ManoelDeveloper-alt/PIBIC-2024-25/helius/outros/internet/info.txt

execulte o gerenciador com sudo (sudo python3 gerenciador.py)
instale o iwlist (sudo apt install wireless-tools)
instale o udhcpc (sudo apt install udhcpc)
