ManoelDeveloper-alt/PIBIC-2024-25/Files/raspberry_pin.png

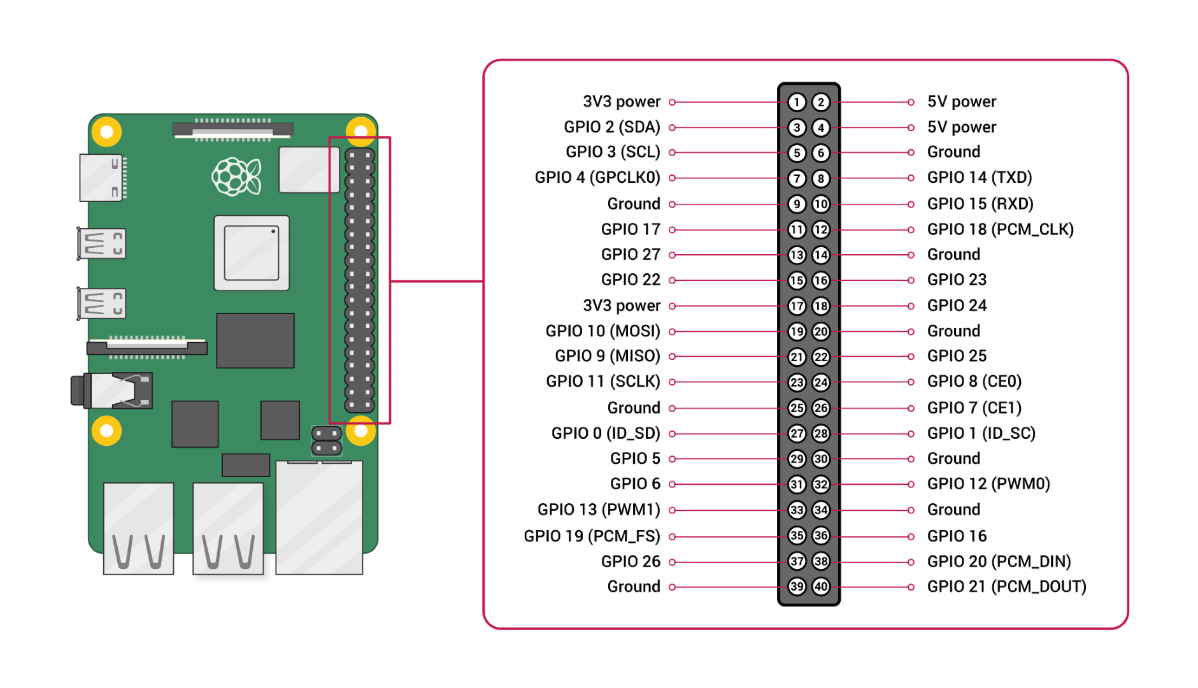
Files/raspberry_pin.png
