ManoelDeveloper-alt/PIBIC-2024-25/3d/esfera_certo.stl

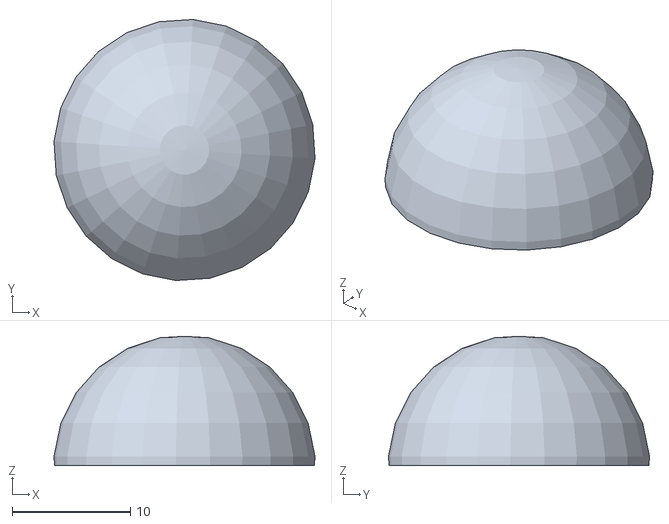
[picture p2: CAD file, 2025-09-12]
3d/esfera_certo.stl
22.0 x 22.0 x 10.9
