ManoelDeveloper-alt/PIBIC-2024-25/3d/roda_pequena.stl

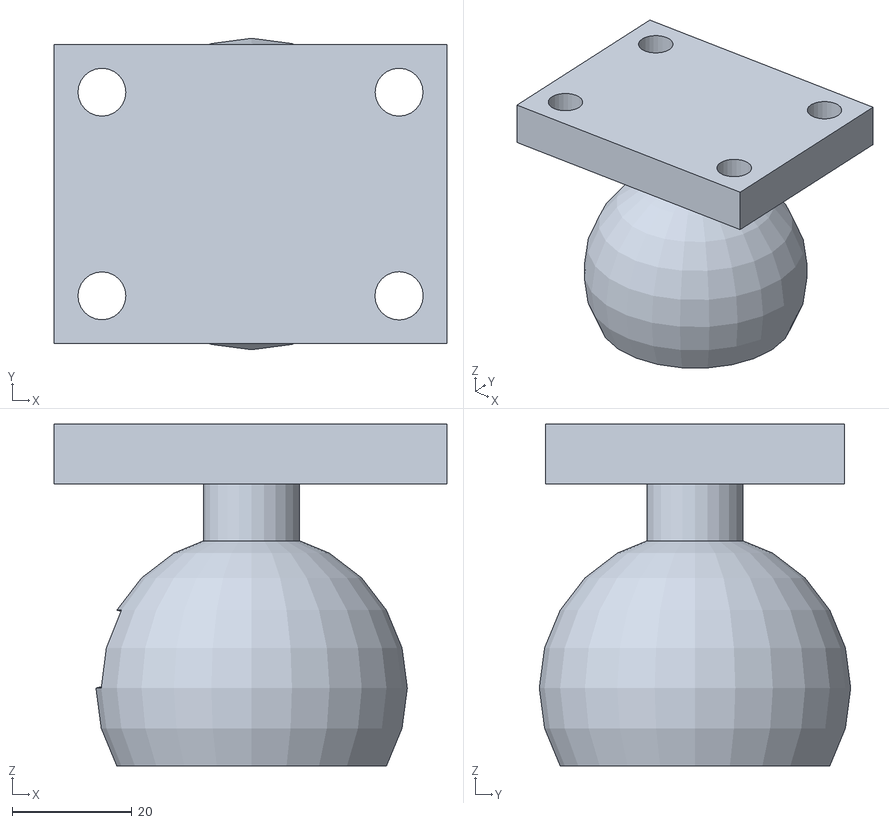
[picture p3: CAD file, 2025-09-12]
3d/roda_pequena.stl
65.6 x 52.0 x 57.1
