ManoelDeveloper-alt/PIBIC-2024-25/3d/esfera_1B.stl

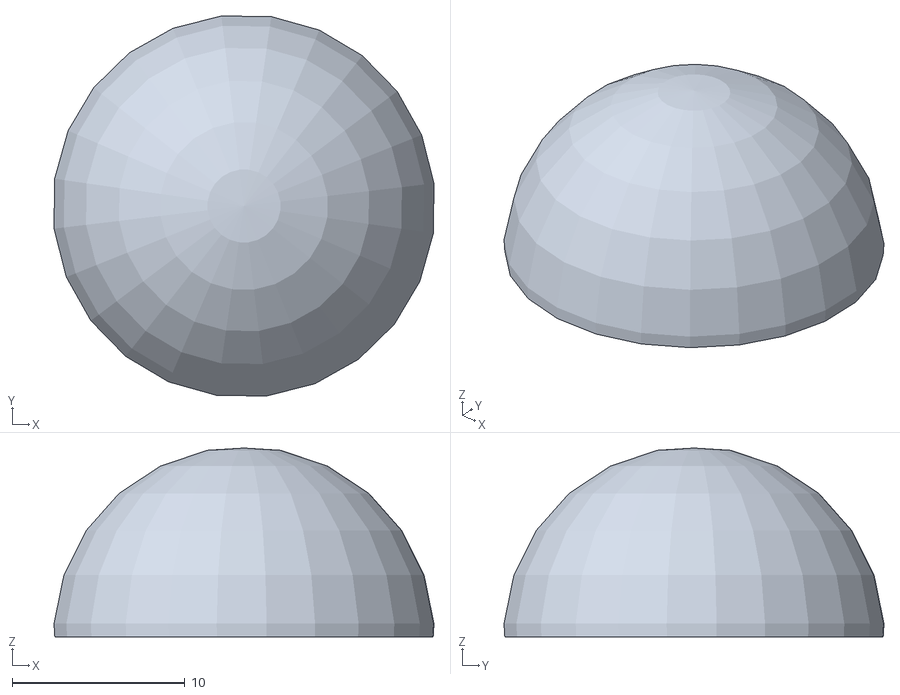
[picture p4: CAD file, 2025-09-12]
3d/esfera_1B.stl
22.0 x 22.0 x 10.9
