ManoelDeveloper-alt/PIBIC-2024-25/3d/esfera_1.stl

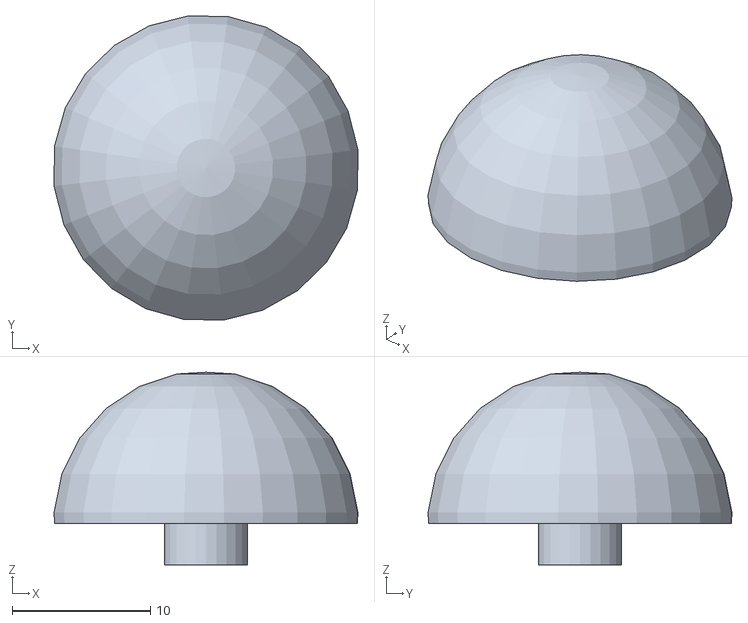
[picture p5: CAD file, 2025-09-12]
3d/esfera_1.stl
22.0 x 22.0 x 13.9
