ManoelDeveloper-alt/PIBIC-2024-25/3d/esfera_certa_dessa_vez.stl

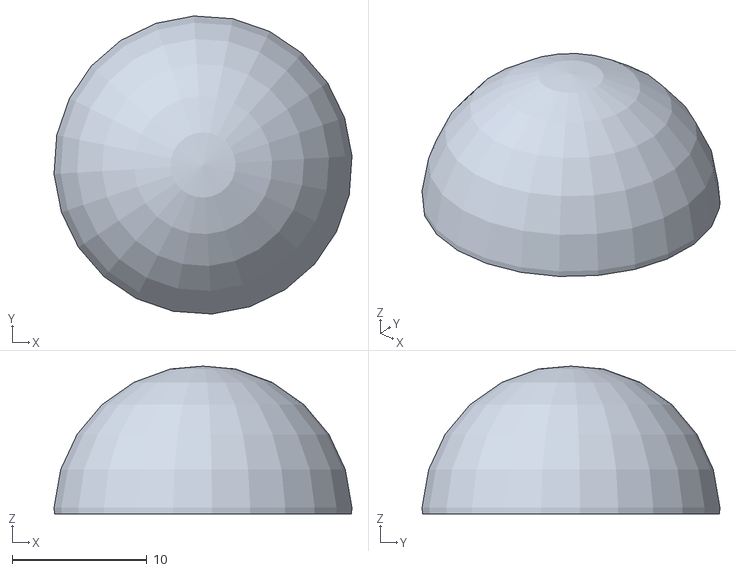
[picture p6: CAD file, 2025-09-12]
3d/esfera_certa_dessa_vez.stl
22.1 x 22.1 x 10.9
