ManoelDeveloper-alt/PIBIC-2024-25/3d/esfera.stl

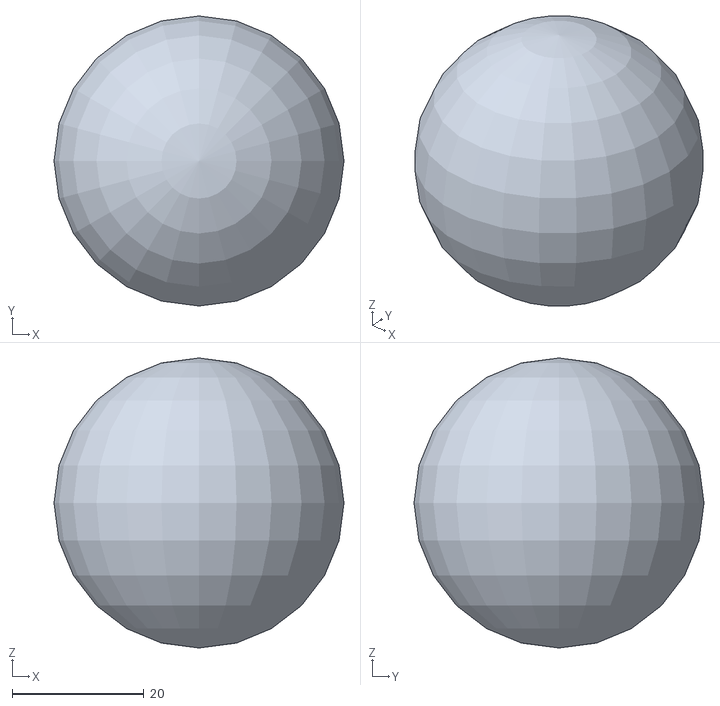
[picture p7: CAD file, 2025-09-12]
3d/esfera.stl
44.0 x 44.0 x 44.0
