ManoelDeveloper-alt/PIBIC-2024-25/3d/esferacombase.stl

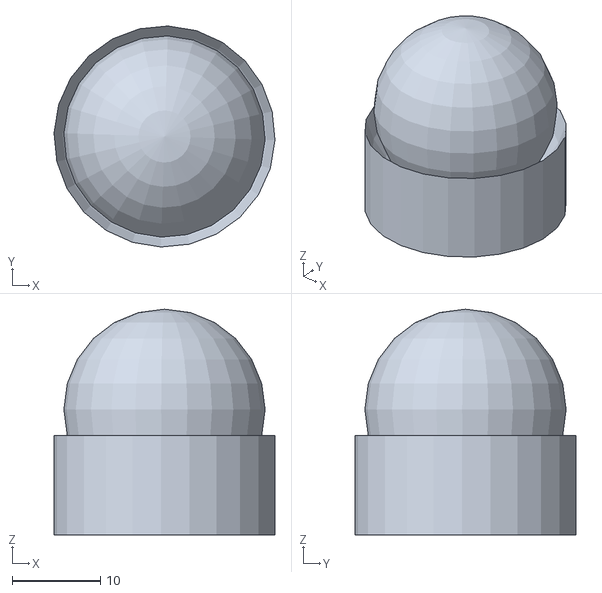
[picture p8: CAD file, 2025-09-12]
3d/esferacombase.stl
25.0 x 25.0 x 25.5
