ManoelDeveloper-alt/PIBIC-2024-25/Files/Astar - Testes/criador_de_mapa/res/borracha.png

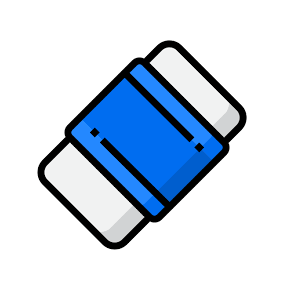
Files/Astar - Testes/criador_de_mapa/res/borracha.png
