ManoelDeveloper-alt/PIBIC-2024-25/Files/Astar - Testes/criador_de_mapa/res/lapis.png

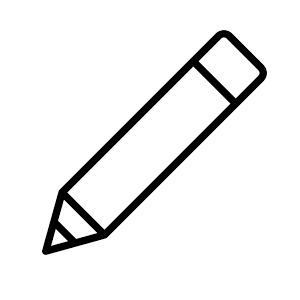
Files/Astar - Testes/criador_de_mapa/res/lapis.png
