ManoelDeveloper-alt/PIBIC-2024-25/placas/motor_energia/teste_regulador.pdf

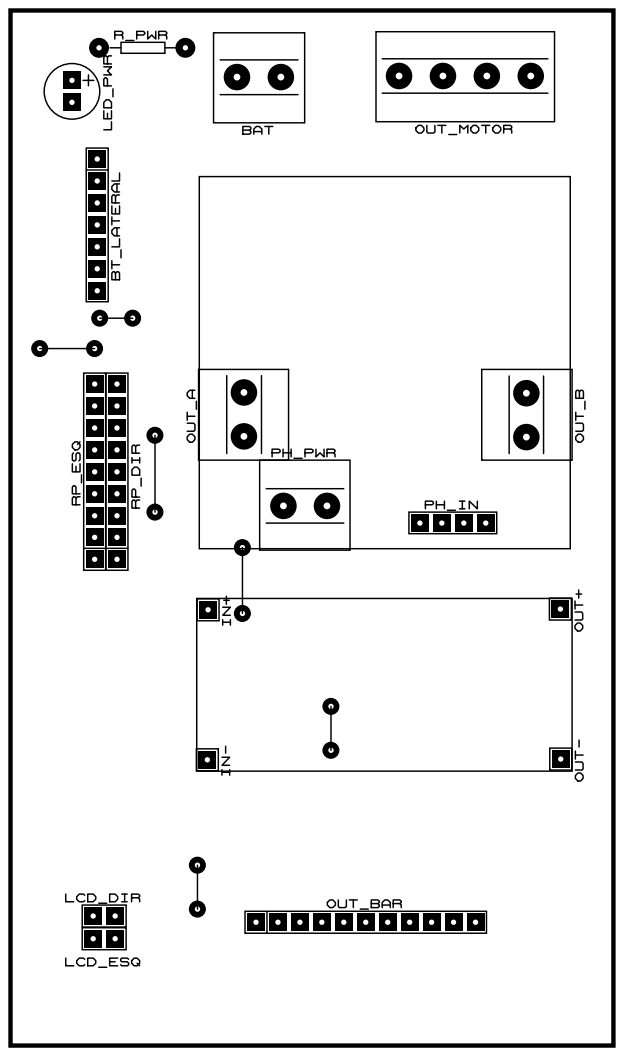
[picture p11: page 1]
