ManoelDeveloper-alt/PIBIC-2024-25/placas/motor_energia/teste_tamanho.pdf

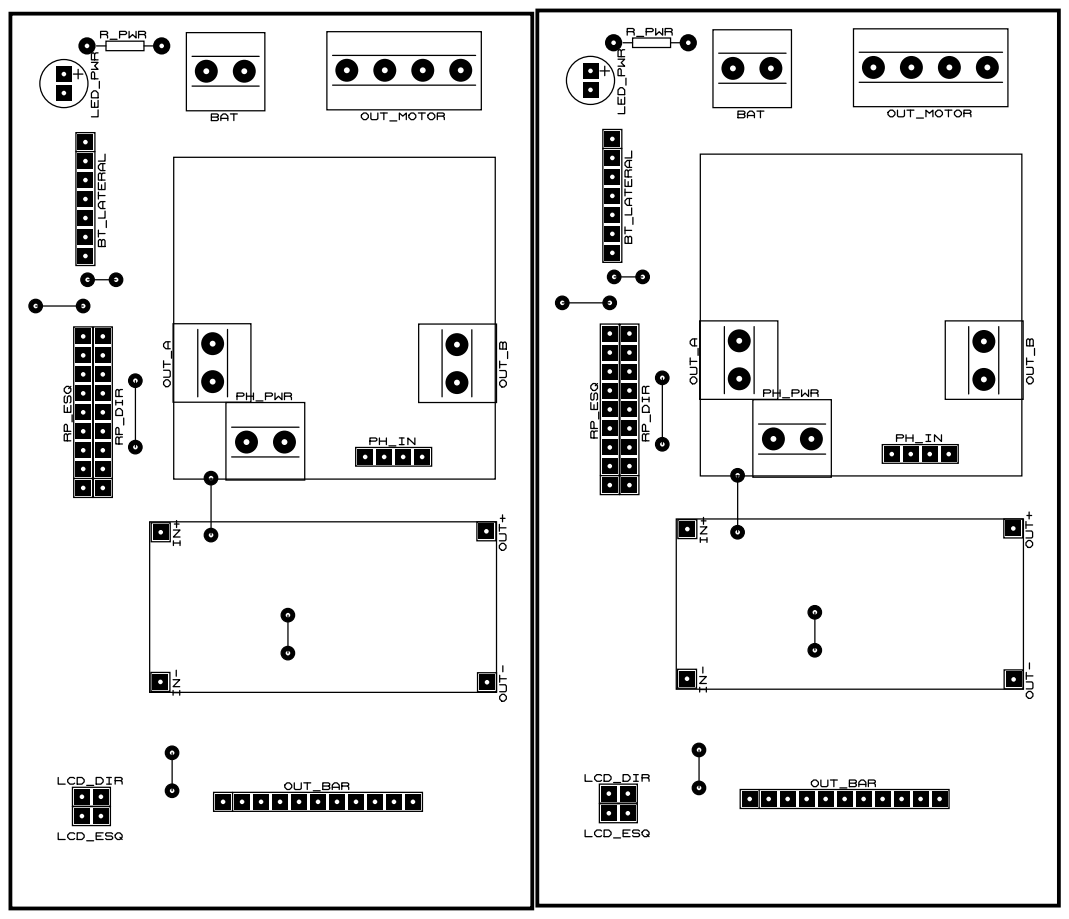
[picture p12: page 1]
