ManoelDeveloper-alt/PIBIC-2024-25/placas/principal - Wallif/teste.pdf

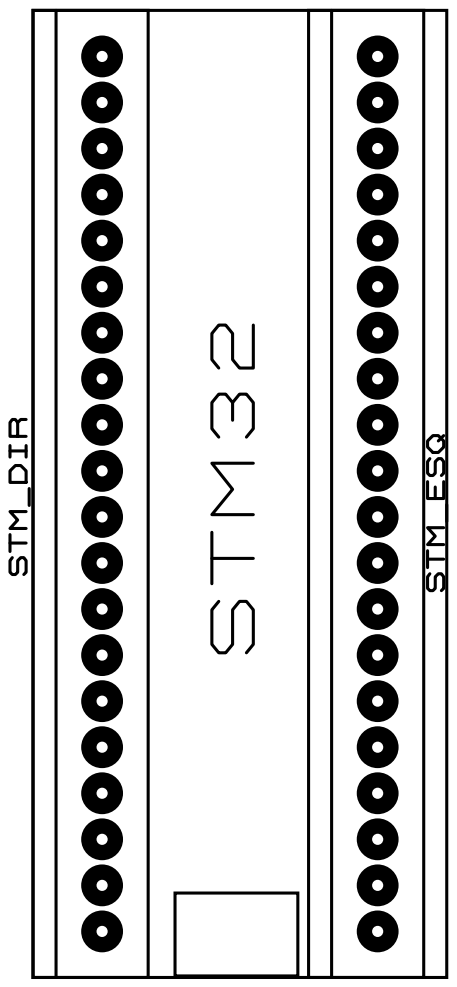
[picture p13: page 1]
