ManoelDeveloper-alt/PIBIC-2024-25/placas/linha/bottom_normal.pdf

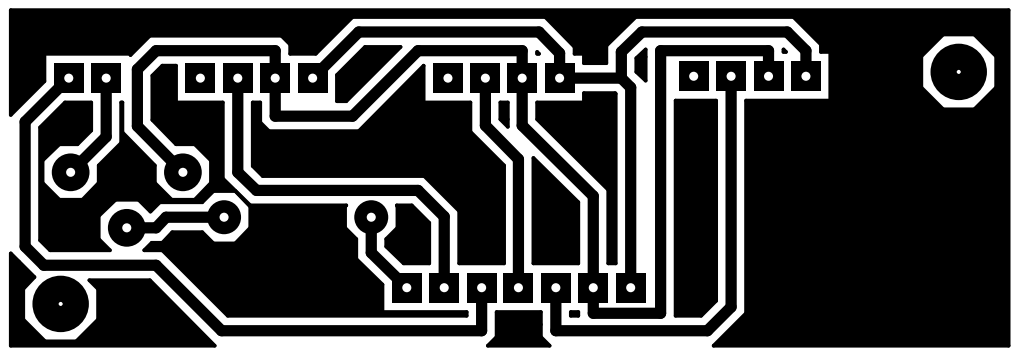
[picture p14: page 1]
