ManoelDeveloper-alt/PIBIC-2024-25/placas/linha/pads_okay.pdf

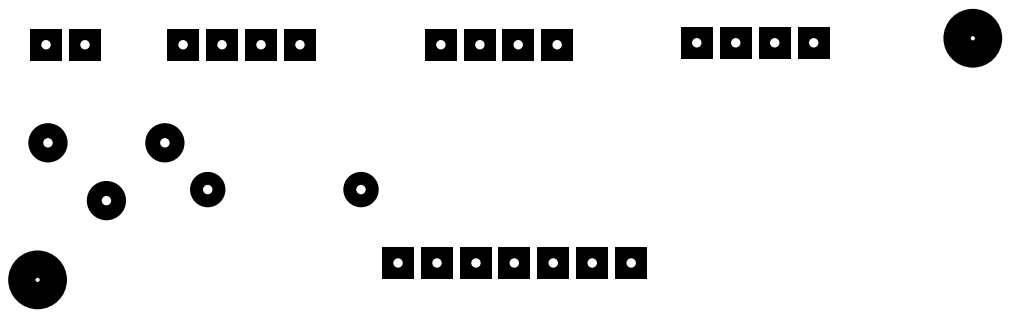
[picture p15: page 1]
