ManoelDeveloper-alt/PIBIC-2024-25/placas/motor_energia/bottom_normal.pdf

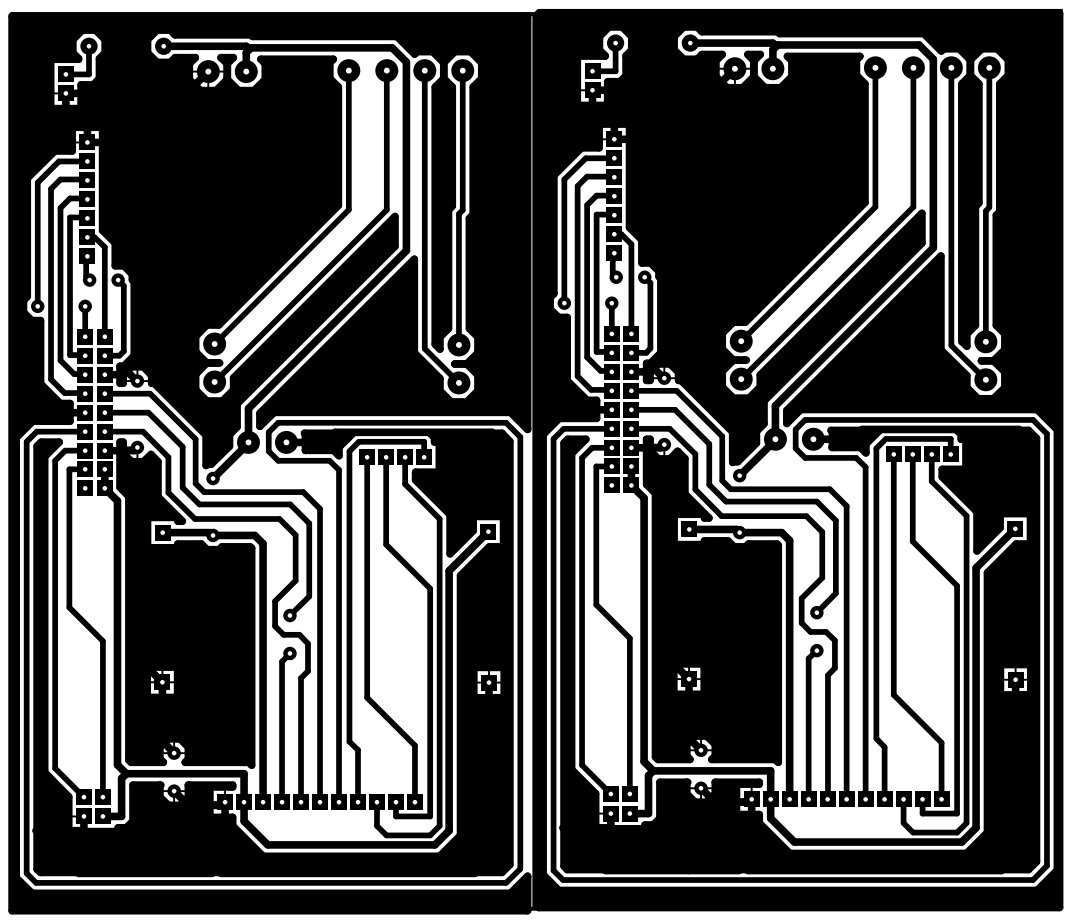
[picture p16: page 1]
