ManoelDeveloper-alt/PIBIC-2024-25/placas/motor_energia/pads.pdf

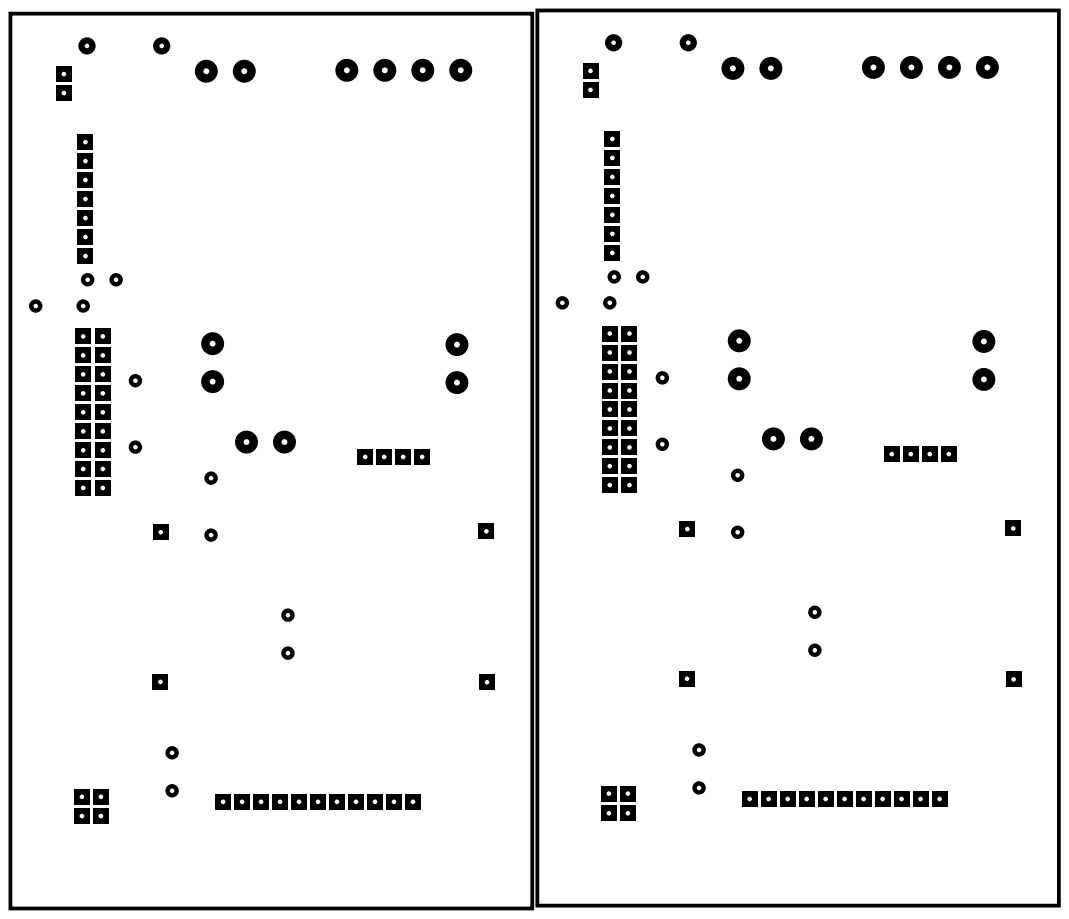
[picture p17: page 1]
