ManoelDeveloper-alt/PIBIC-2024-25/(list of files, drawings)

Other design files:
placas/Arduino - wallif/Arduino.DSN
placas/Arduino - wallif/Arduino.LYT
placas/botao/botao.DSN
placas/botao/botao.LYT
placas/linha/linha.LYT
placas/motor_energia/motor_energia.DSN
placas/motor_energia/motor_energia.LYT
placas/principal - Wallif/principal.DSN
placas/principal - Wallif/principal.LYT
placas/principal/principal.DSN
placas/principal/principal.LYT
